bristol-communal-modular/yorick/README.md

# BCM Yorick Synth

A little noisy synth thing made for the Machina Bristonica festival.

## Contact

Come down the Bristol Hackspace on a Tuesday night to say hello.

## License

The BCM Yorick Synth is shared under an [Attribution-NonCommercial-ShareAlike 4.0 International License](https://creativecommons.org/licenses/by-nc-sa/4.0/)

This means that you can share the info here around, and transform or build upon the circuits and designs in here, as long as you share anything you do under the same license and give BCM a shout-out.

We don't license this for commercial purposes, but if you'd like to run a workshop with this or some variation of it, just get in contact and we can sort something out.
If you want to build a couple to sell to your mates then we're pretty fine with that as well.
