bristol-communal-modular/yorick/docs/README.md

# Docs

The files here are mainly from when Yorick was being designed.

* The first diagram when we were figuring out the functionality
* Layouts to see the spacing with four or five potentiometers
* A document outlining the mathematics for how the filter works

There is also a PDF of the manual which is laid out so it can be printed at A3 size and the folded into a nice booklet.
