bristol-communal-modular/yorick/docs/design/filter-design/4069-state-variable-filter.pdf

# 4069 State Variable Filter

Guy John
guy@rumblesan.com

August 18, 2023

## 1 Introduction

The design for the Yorick filter was found on a thread on the the electro music forum. (https://electro-music.com/forum/topic-69887.html) A user called Hammer had created a filter based around the CD4069 CMOS inverter IC which could run off 5 volts, and give CV control of the cutoff. This document tries to run through the maths on how it works, and is mainly to try and help with figuring out the correct values for the design.
In the first version that Hammer shared they used JFETs as a variable resistance element to handle the voltage control, but specified the 2N5457 which is getting a bit pricy to get hold of, and isn’t ideal if we want to keep things cheap. The J113 JFET should work reasonably well in it’s place, but it’s worth running through the maths to make sure, and see if and how we can improve things.

1

### 1.1 CMOS Inverter Linear Applications

### 1.1.1 Inverters as OpAmps

The use of 4069 inverters as amplifiers isn’t that uncommon, and it turns out that they can work pretty well. This thread on ModWiggler (https://www.modwiggler.com/forum/viewtopic.php?t=256633&hilit=4069+amplifier) has some really useful info on the subject, and famously the Wasp filter uses inverters as the integrators that are paired with the 3080 OTAs.
In terms of the analysis, we can assume that it will follow similar behaviour to an inverting op-amp circuit.

Figure 1: A CMOS inverter biased for linear mode operation, taken from the National Semiconductor Application Note 88 July 1973

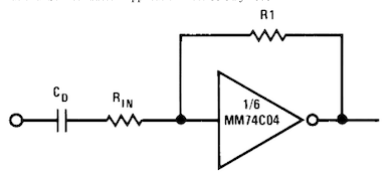
[picture p4: figure]

Here the equation for the output voltage is Vout = −Vin ∗

R1
Rin

### 1.1.2 Inverters as Integrators

Knowing that the inverter works roughly the same as an inverting op-amp, we can also make the same assumption about how it works as an integrator. Assuming that the input of the inverter self-biases to half the supply voltage, we can treat it as a virtual ground, meaning that the sum of all currents at that point should equal zero. This means that the current through the capacitor C will be equal to the current flowing through Ri
Working in the Laplace domain to make the analysis easier, we can state the following:

s is a complex frequency variable that can represent the phase and amplitude of a signal.

vin(s) is the input voltage in terms of s.

Ri

is the value of the resistor through which the input signal is fed to the integrator.

2

Figure 2: A CMOS inverter based integrator

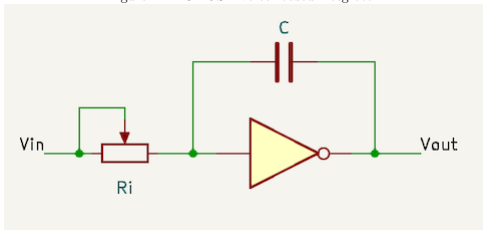
[picture p5: figure]

C is the value of the integrators’ capacitors.

vc(s) is the voltage across the capacitor in terms of s.

ic(s) is the current flowing into the capacitor in terms of s.

vc(s) = ic(s)
Cs
ic(s) = vin(s)
Ri
vout(s) = −vc(s)

= −

ic(s)
Cs

= −

vin(s)
Ri

1
Cs

= −

vin(s)
CsRi

vout(s)
vin(s)

= −

1
CsRi

We can take the above equation and turn it into a transfer function α(s).

α(s) = −

1
CsRi

(1)

### 1.2 Filter Analysis

For the time being we’re going to ignore the JFETs and any affect that they might have on the circuit. Having them in parallel with the variable resistors

3

Figure 3: The CMOS inverter based filter


means they can affect the overall resistance of the input to the two integrators and change the frequency response, but we can investigate their affect later. The filter circuit actually gives us the high-pass, band-pass and low-pass signals as outputs, but we’ll be primarily focussed on the low-pass signal here. It’s still helpful to refer to these signals as vhp, vbp and vlp though.

### 1.2.1 Resonance Feedback Amplifier

Inverter U4D along with resistors Rq, Rqf, Rqmax, and potentiometer V Rq is responsible for the amount of band-pass signal getting fed back to the input, which controls the overall resonance. This is just an inverting amplifier with the potentiometer set to change the input resistance and so give manual control over the gain. The minimum gain will be Rqf
V Rq+Rqmax , and the maximum gain will be Rqf
Rqmax , but these will be negative because the amplifier is inverting. The setup with the potentiometer being used as a variable resistance instead of being tied to ground is because the bias point for the filter circuit is actually at V cc/2, but we would have to create this voltage as it doesn’t currently exist in the circuit.
To simplify the equations for the time being, we’ll just say this is a gain factor −β which is controlled by the potentiometer rotation.

### 1.2.2 Input Mixer

The first stage of the filter is a summing mixer built around U4A.

vin(s)

Rin

+

vhp(s)
Rf

+

vlp(s)

Rlp

+

−βvbp(s)
Rq
= 0 | (2)

It is useful to note that vbp(s) = vhp(s)α(s), and vlp(s) = vhp(s)α(s

2
). Also
to simplify here we’ll set Rlp == Rf .

4

### 1.2.3 High-pass

vhp(s)
Rf

= −

vin(s)

Rin

−

vlp(s)
Rf

−

vbp(s) − β
Rq
vhp(s)
Rf

= −

vin(s)

Rin

−

vhp(s)α(s

2
)
Rf

−

−βvhp(s)α(s)
Rq
vin(s)

Rin

= −

vhp(s)
Rf

−

vhp(s)α(s

2
)
Rf

−

−βvhp(s)α(s)
Rq
Hhp(s) = vhp(s)
vin(s)
vin(s)

Rin

= −vhp(s)( 1
Rf

+

α(s

2
)
Rf

+

−βα(s)
Rq

)

1

Rin

= −Hhp(s)( 1
Rf

+

α(s

2
)
Rf

+

−βα(s)
Rq

)

−1

Rin

= Hhp(s)( 1
Rf

+

α(s

2
)
Rf

+

−βα(s)
Rq

)

Hhp(s) = | −1/Rin

1
Rf

+

α(s

2)
Rf

+

−βα(s)
Rq

=

−Rf /Rin

1 + −βRf α(s)
Rq

+ α(s

2)

### 1.2.4 Low-Pass

Hlp(s) = vlp(s)
vin(s)

=

vhp(s)
vin(s)

α

2
(s)

=

−Rf /Rin

1
α²(s) +

Rf −β
Rqα(s) + 1

=

−Rf /Rin

1
α²(s) + −β

Rf
Rq

1
α(s) + 1

=

−Rf /Rin

1
(− 1
CsRi

)

2 + −β

Rf
Rq

1
− 1
CsRi

+ 1

=

−Rf /Rin

1
1
(sCRi

)²

+ β

Rf
Rq

1
1
sCRi

+ 1

=

−Rf /Rin

s

2(CRi)

2 + β

Rf
Rq

sCRi + 1

At this point we’ll also make the simplification that Rq = Rf , giving the

5

final transfer function for the low-pass output.

Hlp(s) = | −Rf /Rin
s
| 2(CRi) 2 + βsCRi + 1

(3)

### 1.2.5 Calculating Gain, Cutoff and Resonance

For reference, the standard second-order filter transfer functions are:

Hlp(s) = | 1
s
| 2T² +
| 1 q
sT + 1
Hbp(s) = | 1

q
| sT + qsT + 1
Hhp(s) = | 1

1
s
| 2T ² +

1
| qsT + 1

By comparing our transfer function with the standard one for a low-pass, we can work out the following.

Pass-band gain, −

Rf

Rin
Cutoff frequency, 1
2πT → x

1
2πCRi
Resonance, 1
β

### 1.3 Calculating Cutoff Frequencies

Given the calculation for frequency, and picking some standard values we can calculate cutoff for different icv values.

Ri

is between 47r and 10k

C is 220nF

f =

1
2πCRi

(4)

for Ri of 47r f = 15395Hz

for Ri of 1k f = 723Hz

for Ri of 5k f = 145Hz

for Ri of 10k f = 72Hz

6

### 1.4 Calculating Resonance

The resonance here is directly proportional to the gain of the resonance feedback stage, with lower gains meaining higher resonances. A resonance value of around 0.5 is a good minimum, with higher values being more resonant.

β =

Rqf

V Rq + Rqmin

res =

1
β

res =

V Rq + Rqmin
Rqf

min res =

Rqmin
Rqf

max res =

V Rq + Rqmin
Rqf

### 1.4.1 Actual Values

If V Rq is 100k, then Rqf will need to be 4k7, giving a final resonance range of,

max res =

V Rq + Rqmax
Rqf

=

100k + 2.2k
4.7k
= 21.7

min res =

Rqmax
Rqf

=

2.2k
4.7k
= 0.47

7
