bristol-communal-modular/yorick/docs/design/early-planning/diagram.png

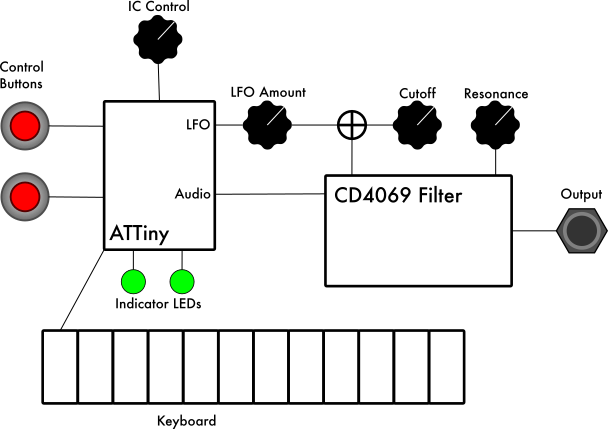
docs/design/early-planning/diagram.png
