bristol-communal-modular/yorick/docs/design/SVGs/Yorick 5 Knobs/yorick-5-knobs-full-ref.png

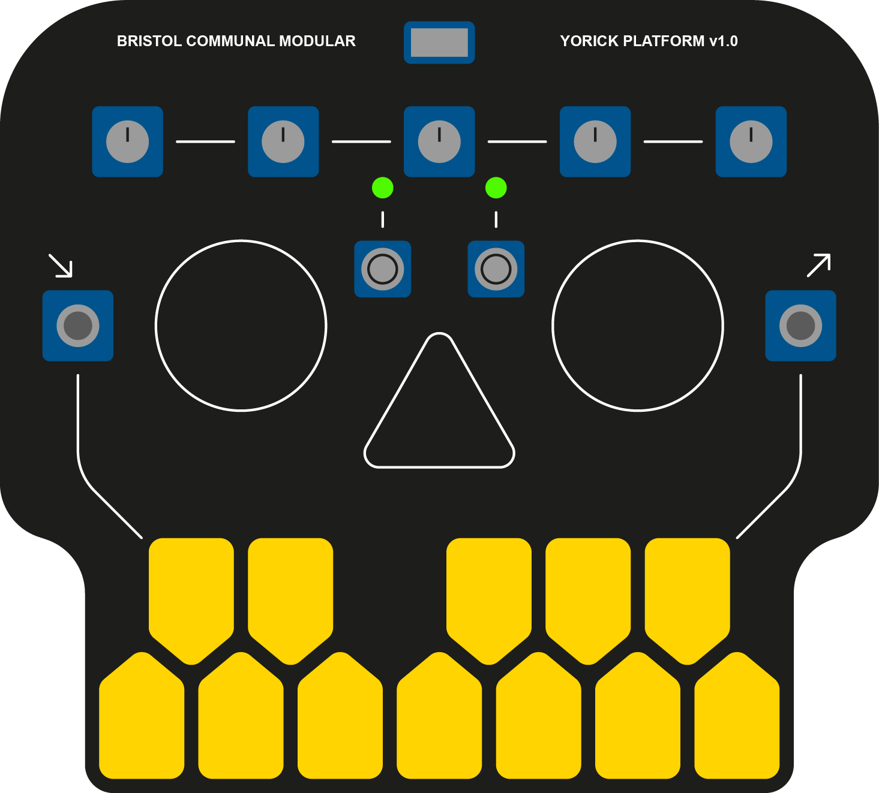
docs/design/SVGs/Yorick 5 Knobs/yorick-5-knobs-full-ref.png
