bristol-communal-modular/yorick/docs/design/SVGs/Yorick 5 Knobs/yorick-5-knobs-lines_notext.png

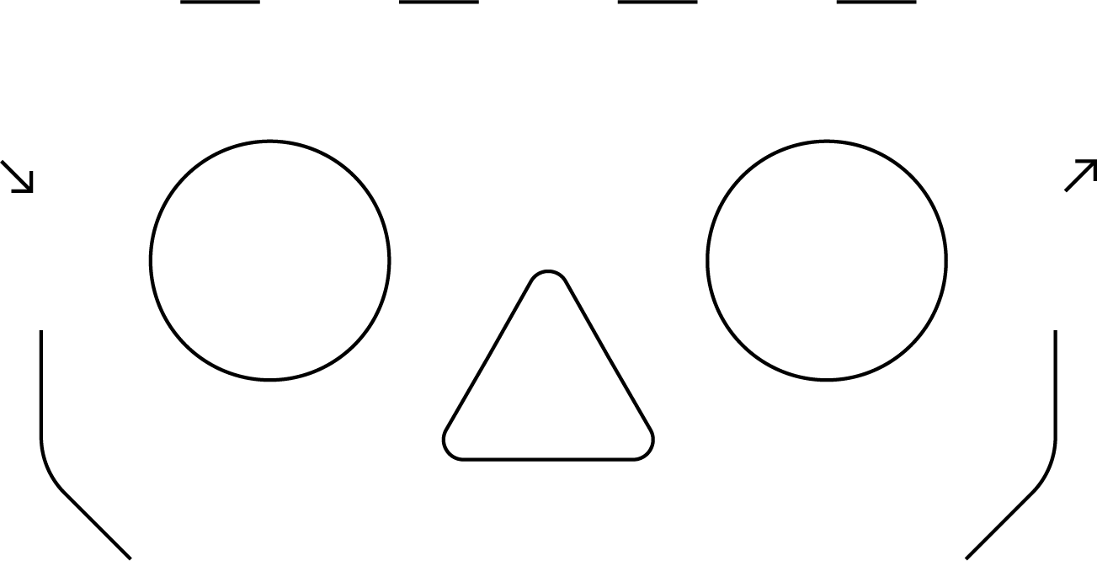
docs/design/SVGs/Yorick 5 Knobs/yorick-5-knobs-lines_notext.png
