bristol-communal-modular/yorick/docs/design/SVGs/Yorick 5 Knobs/yorick-5-knobs-teeth.png

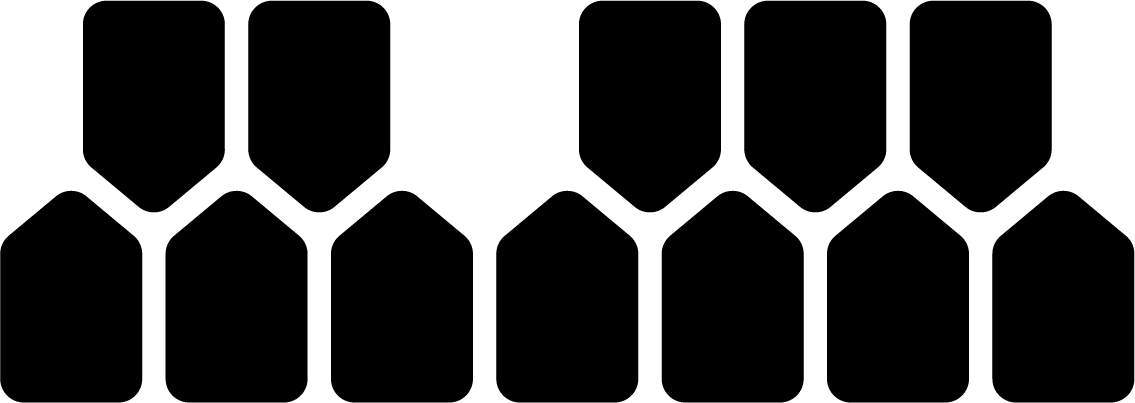
docs/design/SVGs/Yorick 5 Knobs/yorick-5-knobs-teeth.png
