bristol-communal-modular/yorick/site/images/yorick.jpg

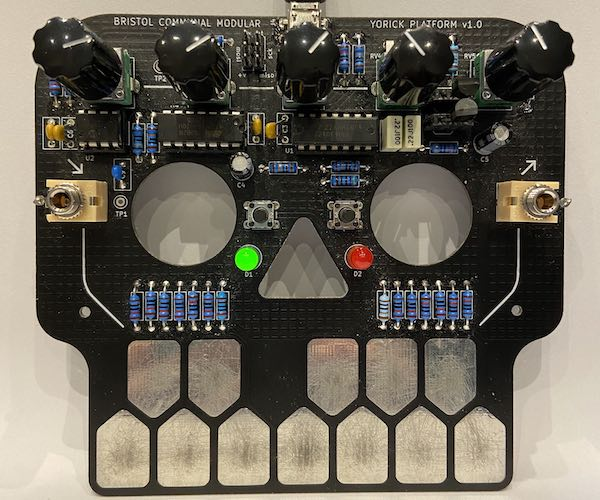
site/images/yorick.jpg
