bristol-communal-modular/yorick/hardware/backplate/Back Plate.dxf

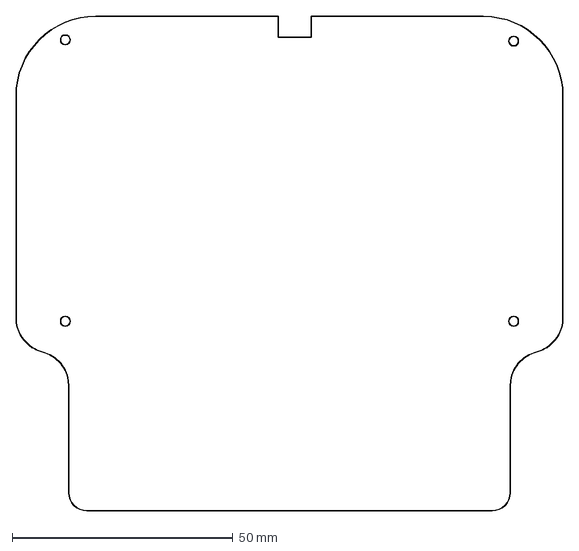
[picture p13: CAD file, 2023-10-26]
hardware/backplate/Back Plate.dxf
124.0 x 112.0 mm
