bristol-communal-modular/yorick/docs/yorick-manual-A3-foldable.pdf

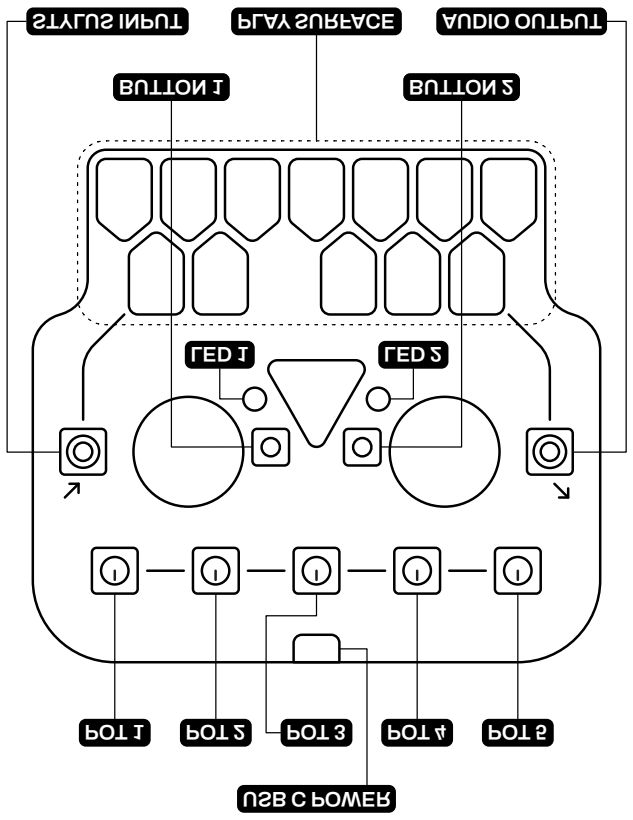
[picture p18: figure]
USB C POWER; PLAY SURFACE; BUTTON 1; BUTTON 2; POT 1; POT 2; POT 3; POT 4; POT 5; LED 1; LED 2; STYLUS INPUT; AUDIO OUTPUT

# YORICK

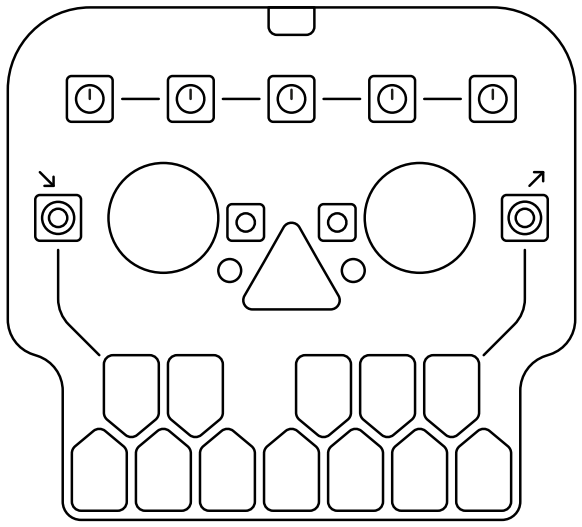
[picture p19: figure]

## BRISTOL COMMUNAL MODULAR

2025

## QUICK START GUIDE VERSION 1.2

## MEET YORICK

# Conjured up from the ashes of acid grooveboxes of yore

# and the souls of crunchy, broken stylophones, Yorick is a

friendly DIY synthesizer from Bristol Communal Modular.

# Yorick is a monophonic synthesizer with a playable

# keyboard and an internal sequencer, which enables you to

record and play back patterns of notes.

# Yorick, a fellow of infinite jest, of most excellent fancy, has

# plenty to offer for any adventurous synthesist, boasting an

# impressive profile full of sweet spots from bass deep

# enough to shake off any cobwebs, to high-pitched timbres

# that can only be described as mysterious

dolphin calls from a far-away dimension...

# Despite his somewhat menacing looks, Yorick does enjoy

# playing with friends and pairs exceptionally well with

effects - be it modular, pedals or software.

# This guide will help you on your journey of getting to know

# Yorick and serves as a useful point of reference for all of

his functionality.

# Godspeed!

## BEFORE YOU START: Useful items and accessories

USB C CABLE | OUTPUT CABLE

### Yorick is powered via

### USB, meaning you can

### breathe life into him

from your computer,

### phone charger or

portable battery bank.

### Yorick is happiest when

plugged into a mixer,

### audio interface or

### a modular system. His

### output is equivalent to

### a hot line level signal

### and benefits from light

### amplification when

used with modular.

### STYLUS CABLE

### Plug a standard 3.5mm

### patch cable into the

### Stylus Input and use the

### other end to touch

### Yorick's gnashers that

### act as a stylophone-

esque play surface.

## POT 1

## POT 1

## POT 1

## POT 2

## POT 2

## POT 2

## POT 3

## POT 3

## POT 3

## POT 4

## POT 4

## POT 4

## POT 5

## POT 5

## POT 5

## SOUND MODE

## PAGE 1: Pitch and tone

## PAGE 2: Modulation

## PAGE 3: Envelope

PITCH

LFO SHAPE

ENV ATTACK

WAVE SHAPE

LFO SPEED

ENV DECAY

LFO DEPTH

LFO DEPTH

LFO DEPTH

CUTOFF

CUTOFF

CUTOFF

RESONANCE

RESONANCE

RESONANCE

Rotate to change

the tuning of

Yorick's oscillator

Rotate to choose

between the four

available shapes

Rotate to adjust

the attack portion

of the amp and

filter envelopes

Rotate to choose

between the four

available wave

shapes

Rotate to

adjust the rate

of the LFO

Rotate to adjust

the decay portion

of the amp and

filter envelopes

Rotate to

adjust how much

the LFO effects

the filter cutoff

Rotate to

adjust how much

the LFO effects

the filter cutoff 1

Rotate to

adjust how much

the LFO effects

the filter cutoff

Rotate to

adjust the cutoff

frequency of the

lowpass filter

Rotate to

adjust the cutoff

frequency of the

lowpass filter

Rotate to

adjust the cutoff

frequency of the

lowpass filter

Rotate to

adjust the

resonance of the

lowpass filter

Rotate to

adjust the

resonance of the

lowpass filter

Rotate to

adjust the

resonance of the

lowpass filter

## LED 2

## LED 1

## LED 2

## LED 2

## BUTTON 2

## BUTTON 2

## BUTTON 2

## BUTTON 2

BUTTON 1 | CHANGE MODE | NEXT PAGE

ON

### 1 If the LFO shape is set to envelope, POT 3 controls

the decay portion of the filter envelope independent of the amp envelope

## POT 1

## BUTTON 2

## POT 2

## SEQUENCER MODE

## RECORDING A SEQUENCE

## PLAYING A SEQUENCE

To record a sequence into Yorick's memory, press and hold Button 2 to clear the sequencer (see detail below).

Once Yorick's mind is clear, tap in the desired sequence using a stylus on the teeth-shaped Play Surface.

Use Pot 2 to to create more expressive sequences by choosing between

a regular note (1/3rd of Pot 2's range), a held note (2/3rd of Pot 2's range) and a rest (3/3rd of Pot 2's range).

Press Button 2 once to start sequencer playback. Press Button 2 again to stop the sequencer.

Rotate Pot 1 to change the speed of

the sequencer.

Press Button 1 to toggle between

Sequence Mode and Sound Mode, so you can sculpt the sound while

the sequencer is running.

Note that it is not possible to start or stop the sequencer whilst in Sound

Mode. For this, you need to switch between the modes using Button 1.

## LED 1

## BUTTON 1 CHANGE MODE

## DELETING A SEQUENCE

To clear Yorick's memory, press and hold Button 2 for two seconds without

touching the Play Surface.

LED 2 will blink rapidly to confirm the

operation has been completed. | 2 seconds

## BUTTON 2

## LED 2

## OFF

## TROUBLESHOOTING

# Yorick is not making any sound

# I can't stop the sequencer!

# Yorick is very noisy

# I'm not sure what mode my Yorick is in

# The sequencer can only be started and stopped in the Sequencer Mode. If you are in Sound Mode and want to stop the sequencer, re-enter the Sequencer Mode by

pressing once on Button 1. When in Sequencer Mode, press Button 2 to stop and start the sequencer.

# Try switching out your USB C cable. If this does not silence Yorick's inner demons, try to power him up from

a different source, such as a portable battery pack.

# When Yorick is in Sound Mode, LED 1 is lit. When navigating between the three available pages in Sound Mode, LED 2 will flash upon changing pages to indicate

which page is currently active.

If Sequencer Mode is active, LED 1 is not lit.

Check that the filter cutoff isn't closed all the way down.

# When recording a sequence, ensure that you aren't recording in just rests with Pot 2 rotated all the way

to the right.

## BRISTOL COMMUNAL MODULAR

# Bristol Communal Modular is a group of circuit explorers and sonic plunderers, meeting at Bristol Hackspace every week to share skills and knowledge around designing and building synth modules, as well as learning how to patch and play a modular system in an informal

and non-judgemental space.

# Running accessible workshops outside of these weekly sessions, the BCM team have rained down pew-pew percussion machines, screaming face masks and electronics knowledge in and around Avon!

# INSTAGRAM bristol_communal_modular

# WEB bristol-communal-modular.github.io

# BRISTOL HACKSPACE bristolhackspace.org
