bristol-communal-modular/yorick/build/yorick-schematic.pdf

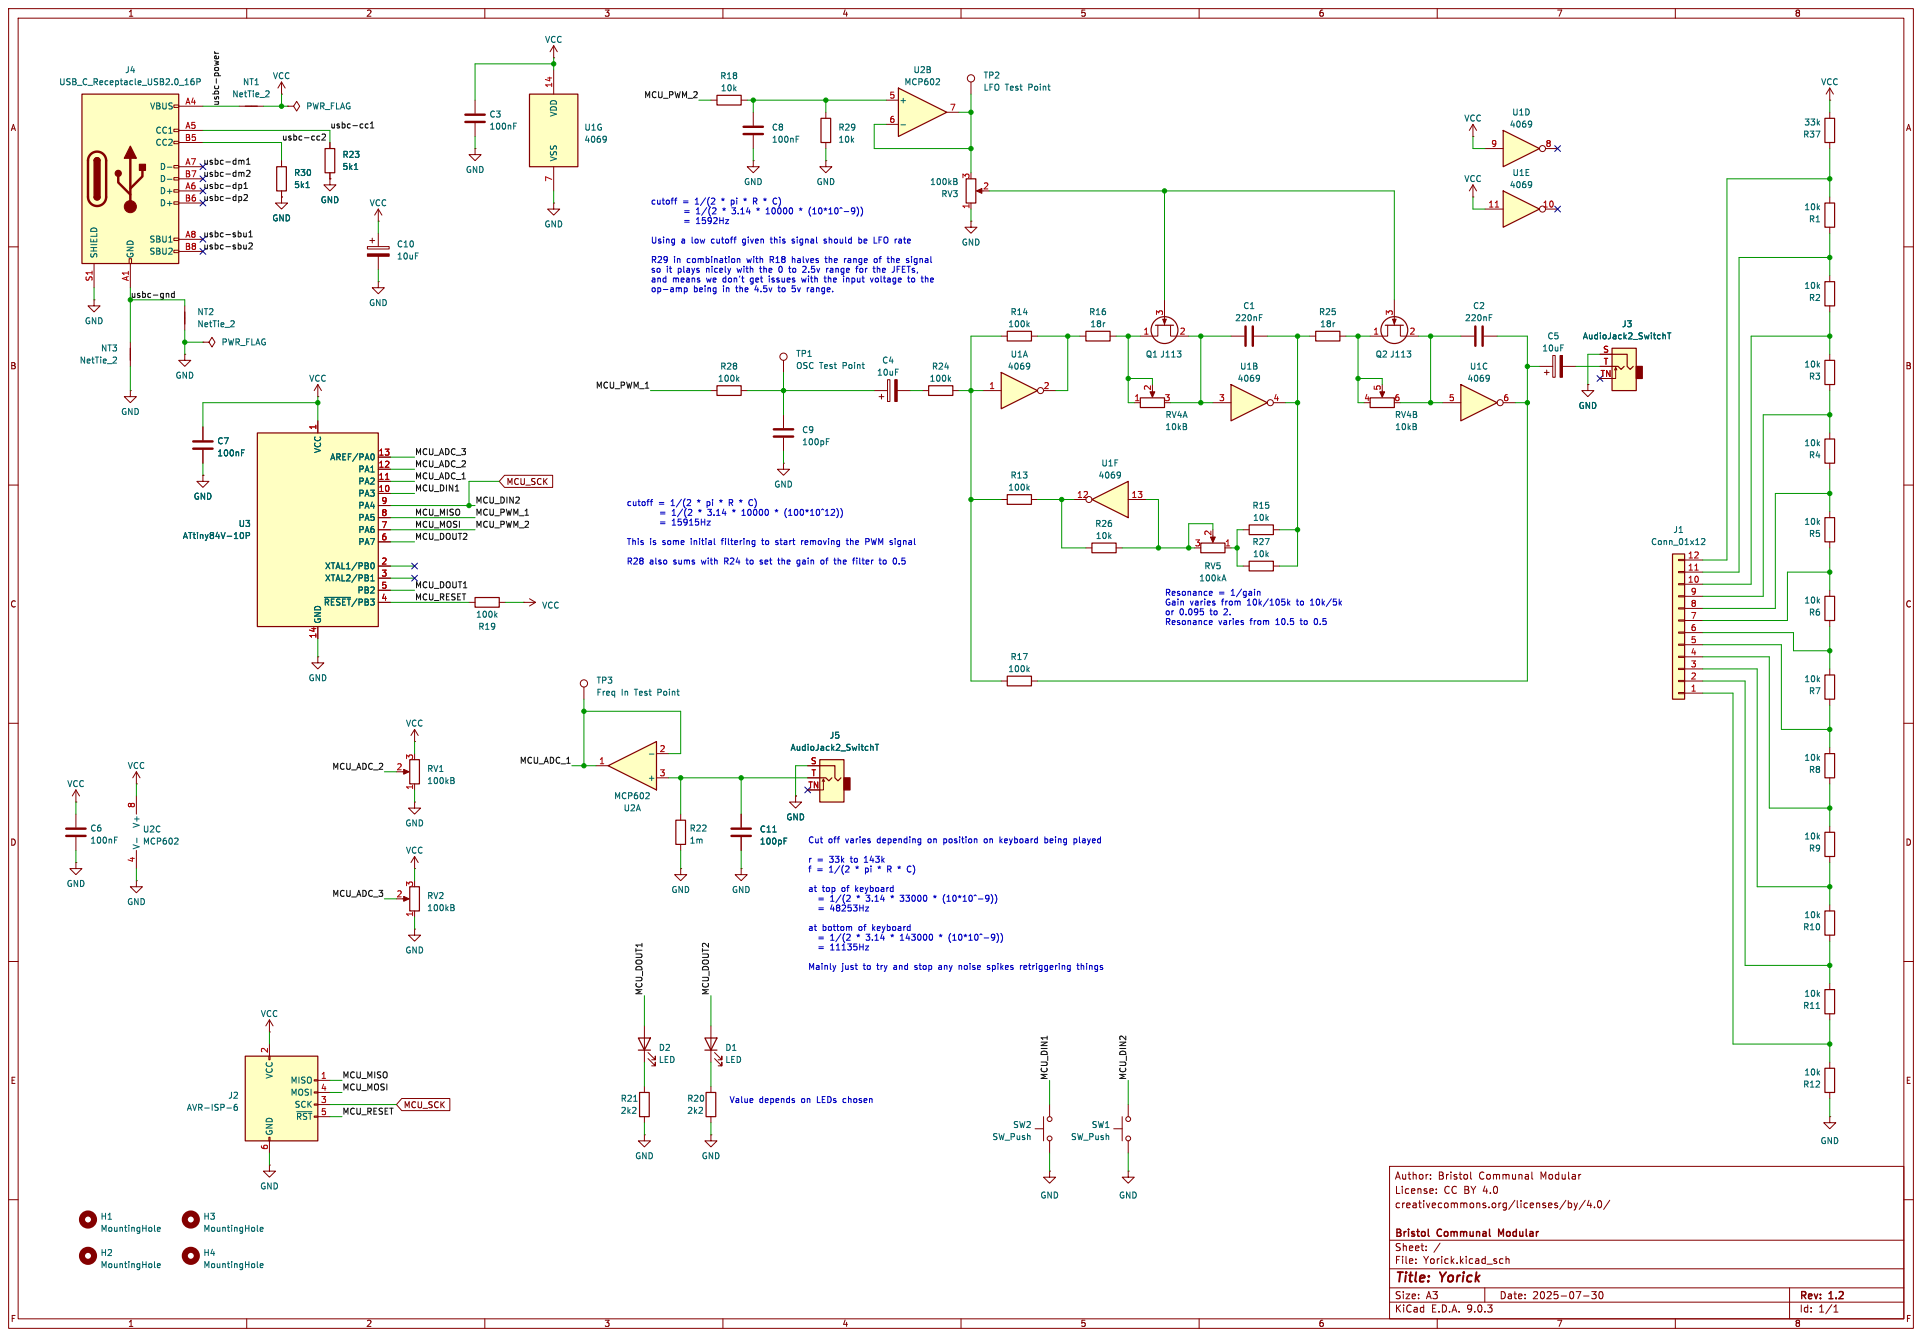
[picture p20: page 1]

1 GND 14 AREF/PA0 13 PA1 12 PA2 11 PA3 10 PA4 9 PA5 8 PA6 7 PA7 6 XTAL1/PB0 2 XTAL2/PB1 3 PB2 5 ~{RESET}/PB34 U3 ATtiny84V-10P GNDV+

6 MISO 1 MOSI 4 SCK 3 ~{RST}5
