bristol-communal-modular/yorick/build/parts-placement-guide.pdf

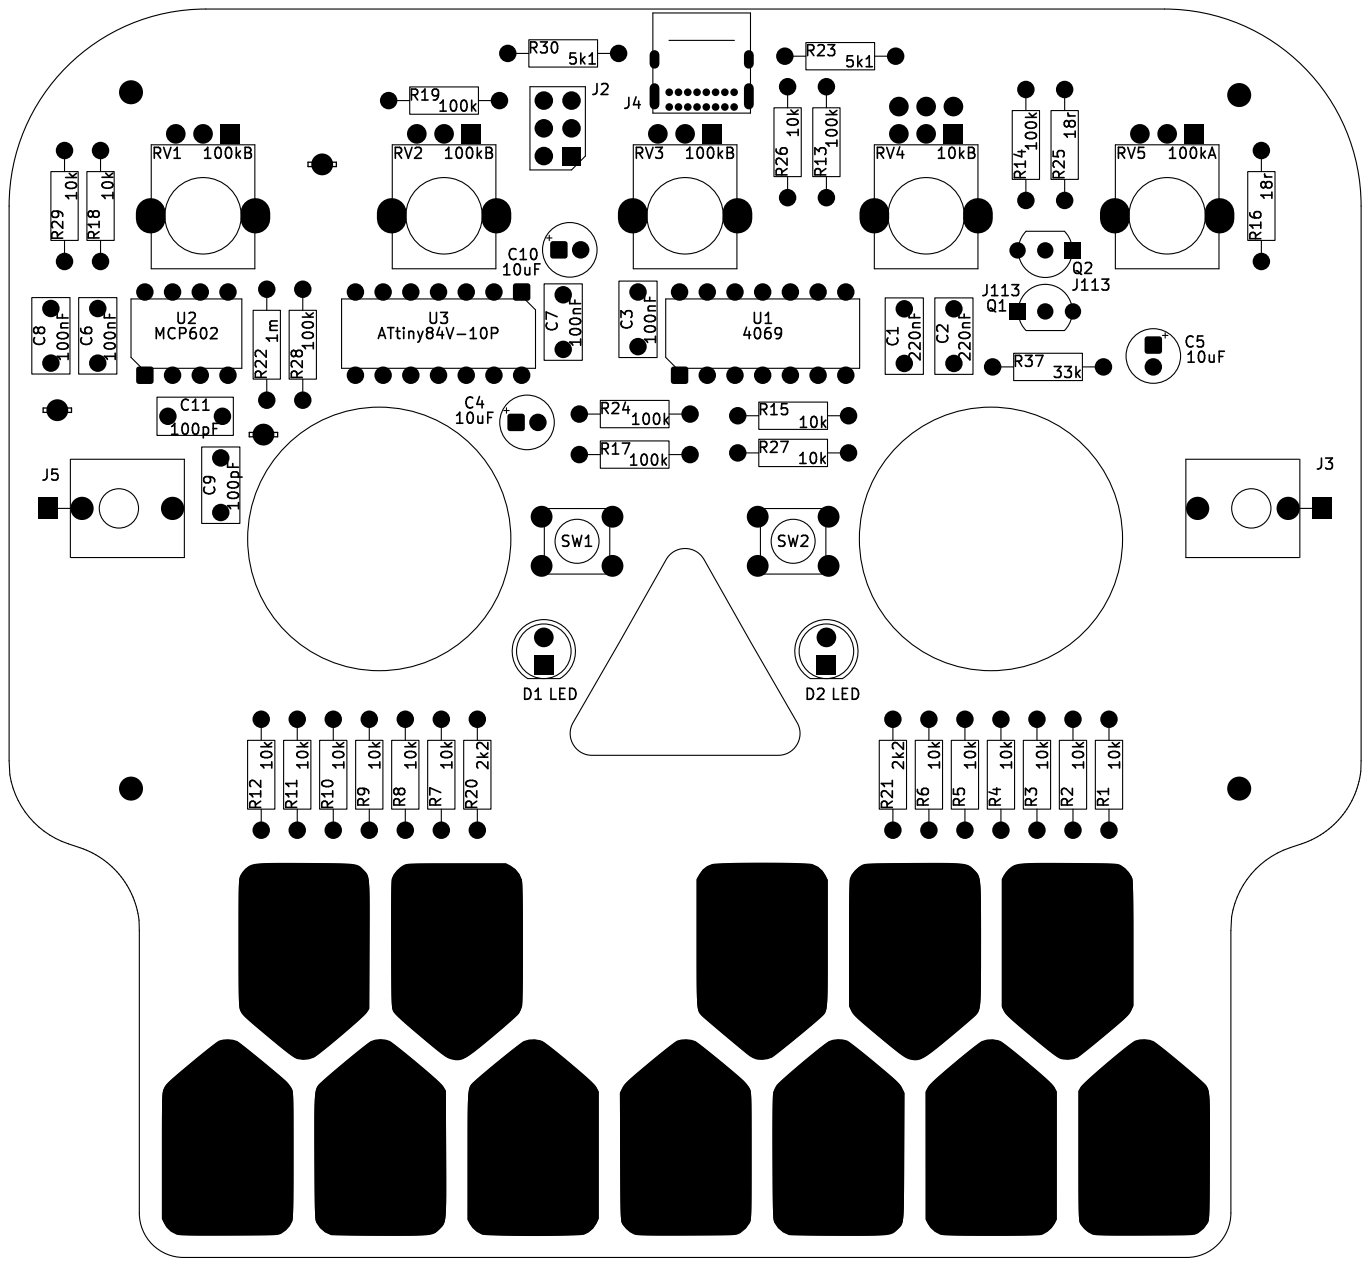
[picture p21: page 1]
