bristol-communal-modular/yorick/firmware/include/envelope.h

#pragma once

#include <stdint.h>

typedef enum {
  ENVELOPE_STOPPED,
  ENVELOPE_RISING,
  ENVELOPE_HOLDING,
  ENVELOPE_FALLING,
} EnvelopeState;

struct envelope_t {
  EnvelopeState state;
  uint16_t value;
  uint16_t attack;
  uint16_t decay;
  uint8_t update_divider;
  uint8_t update_counter;
};

typedef volatile struct envelope_t Envelope;

void envelope_init(Envelope *e, uint8_t update_divider);

void envelope_set_attack(Envelope *e, uint16_t attack);

void envelope_set_decay(Envelope *e, uint16_t decay);

void envelope_start(Envelope *e);

void envelope_release(Envelope *e);

void envelope_tick(Envelope *e);

uint8_t envelope_8bit_value(Envelope *e);
