bristol-communal-modular/yorick/(commit log)

2023-06-18 Attiny Chip Change
    [bcm-machina-noise.kicad_sch]
2023-06-18 set schematic symbol to new USBpower footprint
    [bcm-machina-noise.kicad_sch]
2023-06-18 fixed errors
    [bcm-machina-noise.kicad_sch]
2023-06-18 more bug fixes
    [bcm-machina-noise.kicad_sch]
2023-06-18 starting layout
    [bcm-machina-noise.kicad_pcb, bcm-machina-noise.kicad_sch]
2023-06-18 USB traces fixed
    [bcm-machina-noise.kicad_pcb, bcm-machina-noise.kicad_sch]
2023-06-19 adapted layout for smaller PCB
    [bcm-machina-noise.kicad_pcb]
2023-06-19 traces tidied up with more space for ground plane
    [bcm-machina-noise.kicad_pcb]
2023-06-20 Finalising traces and ground plane, all errors removed
    [bcm-machina-noise.kicad_pcb, bcm-machina-noise.kicad_sch]
2023-06-20 fixed usb lug holes
    [bcm-machina-noise-B_Cu.gbl, bcm-machina-noise-B_Mask.gbs, bcm-machina-noise-B_Silkscreen.gbo, bcm-machina-noise-Edge_Cuts.gm1, bcm-machina-noise-F_Cu.gtl, bcm-machina-noise-F_Mask.gts, bcm-machina-noise-F_Silkscreen.gto, bcm-machina-noise-NPTH.drl]
2023-07-02 Fixing circuit for LFO output
    [bcm-machina-noise.kicad_sch]
2023-07-02 Moving kicad files into its own directory
    [bcm-machina-noise.kicad_pcb, bcm-machina-noise.kicad_sch]
2023-07-05 Updating with new firmware not using arduino libs
2023-07-06 Actually getting the interrupts to work and making a wave
2023-07-08 Adding filter design doc
    [bcm-machina-noise.kicad_sch]
2023-07-08 Updating schematic with fixes and changes
    [bcm-machina-noise.kicad_sch]
2023-07-09 updating filter design calculations for resonance
    [bcm-machina-noise.kicad_sch]
2023-07-09 more tweaks to resonance values
    [bcm-machina-noise.kicad_sch]
2023-07-09 Update filter design pdf
2023-07-09 A few more schematic tweaks
    [bcm-machina-noise.kicad_sch]
2023-07-09 Updating usb power connection
    [bcm-machina-noise.kicad_sch]
2023-07-18 updated pcb layout
    [bcm-machina-noise.kicad_pcb]
2023-07-18 clearance error fix
    [bcm-machina-noise.kicad_pcb]
2023-07-19 Updating PCB layout page info and tidying fab text
    [bcm-machina-noise.kicad_pcb]
2023-07-19 Adding gerbers for rev02
    [bcm-machina-noise-B_Cu.gbl, bcm-machina-noise-B_Mask.gbs, bcm-machina-noise-B_Silkscreen.gbo, bcm-machina-noise-Edge_Cuts.gm1, bcm-machina-noise-F_Cu.gtl, bcm-machina-noise-F_Mask.gts, bcm-machina-noise-F_Silkscreen.gto, bcm-machina-noise-NPTH.drl]
2023-07-19 Increasing board edge copper clearance and recreating zones
    [bcm-machina-noise-B_Cu.gbl, bcm-machina-noise-B_Mask.gbs, bcm-machina-noise-B_Silkscreen.gbo, bcm-machina-noise-Edge_Cuts.gm1, bcm-machina-noise-F_Cu.gtl, bcm-machina-noise-F_Mask.gts, bcm-machina-noise-F_Silkscreen.gto, bcm-machina-noise-NPTH.drl]
2023-07-23 Get oscillator playing pitches correctly
    [main.c]
2023-07-23 Look up pitches from larger pitch table
2023-07-24 Adding led flasher code
2023-07-24 Making octave controllable and adding LED feedback
2023-07-29 Getting led flasher working better
2023-08-16 Adding kicad schematic for filter layout diagram
    only used for the picture in the filter design doc
    [filter-layout.kicad_sch]
2023-08-18 Tweaks to circuitry
    Fixing bugs
    Changing some values
    Adding another potentiometer
    [bcm-machina-noise.kicad_pcb, bcm-machina-noise.kicad_sch]
2023-08-18 Corrections to filter design
2023-08-19 Changing pinout for the micro controller
    [bcm-machina-noise.kicad_sch]
2023-08-19 Updating envelope
    should be safe for use in interrupts
    has rate divider
    now has hold
2023-08-21 new Yorick PCB created with SVG graphics
    [Yorick.kicad_pcb, Yorick.kicad_sch, bcm-machina-noise.kicad_pcb, yorick-5-knobs-base_outline.dxf]
2023-08-22 components placed, routing commenced!
    [Yorick.kicad_pcb, Yorick.kicad_sch, yorick-5-knobs-outline.dxf]
2023-08-23 Yorick tracing
    [Yorick.kicad_pcb, yorick-5-knobs-base_outline.dxf, yorick-5-knobs-outline.dxf]
2023-08-24 Yorick pcb silkscreen edit
    [Yorick.kicad_pcb]
2023-08-25 fixing the warnings and simplifying the pcb routing a bit more
    [Yorick.kicad_pcb, Yorick.kicad_sch]
2023-08-25 Adding logo, quote, and mounting holes
    [Yorick.kicad_pcb, Yorick.kicad_sch]
2023-08-26 Removing some parts from BOM
    [Yorick.kicad_pcb, Yorick.kicad_sch]
2023-08-26 Recreating interactive bom
2023-08-26 moving prototype project files into own folder
    [bcm-machina-noise.kicad_pcb, bcm-machina-noise.kicad_sch]
2023-08-26 Adding copper keepout around teeth
    [Yorick.kicad_pcb]
2023-08-26 Creating gerbers for new layout
    [Yorick-B_Cu.gbl, Yorick-B_Mask.gbs, Yorick-B_Silkscreen.gbo, Yorick-Edge_Cuts.gm1, Yorick-F_Cu.gtl, Yorick-F_Mask.gts, Yorick-F_Silkscreen.gto, Yorick-NPTH.drl]
2023-09-05 Updating inputs and outputs for new board design
2023-09-07 Get oscillator tuning working
    [main.c]
2023-09-07 Making param manager work correctly
    [main.c, param_manager.c, param_manager.h]
2023-09-07 Fixing issues with lfo and envelopes
    [main.c]
2023-09-08 Update led flashers to use global clock
2023-09-08 Update waves to be 0 to 255 value samples
2023-09-09 Adding button code
2023-09-09 Fixing resistor value for keyboard scaling
    [Yorick.kicad_sch]
2023-09-09 Adding scaling function for keyboard adc values
2023-09-09 Switching over to keyboard code
2023-09-11 Fixing button code issue
    [button.c]
2023-09-11 Changing value for opamp pulldown resistor
    [Yorick.kicad_pcb, Yorick.kicad_sch]
2023-09-12 Tweaks to sequencer and fixing tests
    [main.c, sequencer.c, sequencer.h]
2023-09-12 Fixing bug with note length
    [main.c, sequencer.c, sequencer.h]
2023-09-12 Tweaking LED display a bit
2023-09-13 rename led flasher to led control
2023-09-13 Tidying up led controller code
2023-09-13 Fix bug with keyboard
    [main.c]
2023-09-13 Fix bug with sequencer missing first note
    [main.c]
2023-09-13 Adding filter envelope
2023-09-13 Make led controller flash alternate
2023-09-13 Improving how LED flashing works for modes
2023-09-14 More resistor value tweaks
    [Yorick.kicad_sch]
2023-09-15 Getting noise lfo to go slower
    [main.c]
2023-09-23 Tweaking values for some parts
    [Yorick.kicad_pcb, Yorick.kicad_sch]
2023-09-23 Adding basic filtering to mod pot inputs
2023-09-23 include interrupts enable/disables in places
    seems to prevent noise in controls
    [main.c]
2023-09-23 Fix tests for control pot
    [main.c]
2023-09-27 Updating parts and build info
    [Yorick.kicad_pcb, Yorick.kicad_sch]
2023-10-07 Tweaking schematic with rev2 fixes
    [Yorick.kicad_sch]
2023-10-07 Changing led resistor values back to 2k2
    [Yorick.kicad_sch]
2023-10-12 Adding capacitors after some testing
    [Yorick.kicad_pcb, Yorick.kicad_sch]
2023-10-12 Recreating gerbers for rev2
    [Yorick-B_Cu.gbl, Yorick-B_Mask.gbs, Yorick-B_Silkscreen.gbo, Yorick-Edge_Cuts.gm1, Yorick-F_Cu.gtl, Yorick-F_Mask.gts, Yorick-F_Silkscreen.gto, Yorick-NPTH.drl]
2023-10-16 Update bom and parts placement guide
    [yorick-bom.csv]
2023-10-21 Finalising gerbers before sending off rev1.1
    [Yorick-B_Cu.gbl, Yorick-B_Mask.gbs, Yorick-B_Silkscreen.gbo, Yorick-Edge_Cuts.gm1, Yorick-F_Cu.gtl, Yorick-F_Mask.gts, Yorick-F_Silkscreen.gto, Yorick-NPTH.drl]
2023-10-26 Added Lasercut Backplate
    Added a back plate I made to reduce short circuit risks. Can be laser cut and has holes that align with screw holes on yorick!
    [Back Plate.dxf]
2023-10-28 Trying to make keyboard less glitchy
    [keyboard.c, keyboard.h]
2023-10-28 Make led flashing more robust
2023-10-29 Adding filtering on the keyboard input
2023-10-29 Making transpose pitch centered in the keyboard
2023-11-25 Bit of tidying repository
    [bcm-machina-noise.kicad_sch]
2023-11-25 tidying kicad folder
2023-11-25 Updating bill of materials
    [Yorick.kicad_pcb, Yorick.kicad_sch, yorick-bom.csv]
2023-11-25 Adding schematic
    [Yorick.kicad_sch]
2024-07-07 Refreshing project for kicad 8
    [Yorick.kicad_pcb, Yorick.kicad_sch]
2024-07-07 More tidying
    [Yorick.kicad_sch, filter-layout.kicad_sch]
2025-07-30 Updating with USB C socket
    [Yorick.kicad_pcb, Yorick.kicad_sch]
2025-07-30 Making usbc tracks larger and fixing facelines
    [Yorick.kicad_pcb]
2025-07-31 Giving yorick a bigger head to accommodate USB C socket
    [Yorick.kicad_pcb, Yorick.kicad_sch]
2025-07-31 Re-creating gerbers, schematic pdf and ibom
    [Yorick-B_Cu.gbl, Yorick-B_Mask.gbs, Yorick-B_Silkscreen.gbo, Yorick-Edge_Cuts.gm1, Yorick-F_Cu.gtl, Yorick-F_Mask.gts, Yorick-F_Silkscreen.gto, Yorick-NPTH.drl]
2025-08-23 Tweaking fab text positioning for new parts placement guide
    [Yorick.kicad_pcb, Yorick.kicad_sch, yorick-bom.csv]
2025-08-23 Removing facelines footprint and drawing graphics as polygons
    [Yorick.kicad_pcb]
2025-08-24 Reorganising schematic to make it clearer what does what
    [Yorick.kicad_pcb, Yorick.kicad_sch]
2025-08-30 Renaming "kicad" folder to "hardware"
    moving gerbers folder and backplate into there as well
    [Back Plate.dxf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]
2025-09-07 Moving design-docs to docs, adding the foldable manual
    [bcm-machina-noise.kicad_sch, filter-layout.kicad_sch]
