bristol-communal-modular/yorick/(notices)

Notices in the files:
hardware/yorick/Yorick.kicad_pcb:
creativecommons.org/licenses/by/4.0
License: CC BY 4.0
